BasementEngineering/halloween-ai-case/cad/fusion/ResidenEvilCase v15.iges

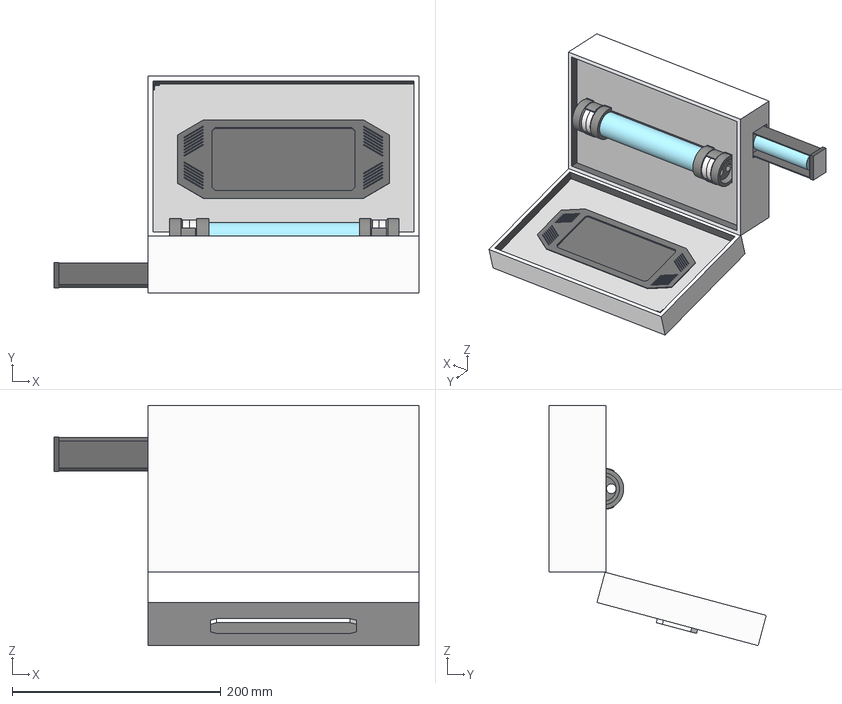
[picture p1: CAD file, 2026-11-10]
cad/fusion/ResidenEvilCase v15.iges
350.0 x 208.5 x 230.4 mm
