BasementEngineering/halloween-ai-case/cad/step/ResidenEvilCase v15.step

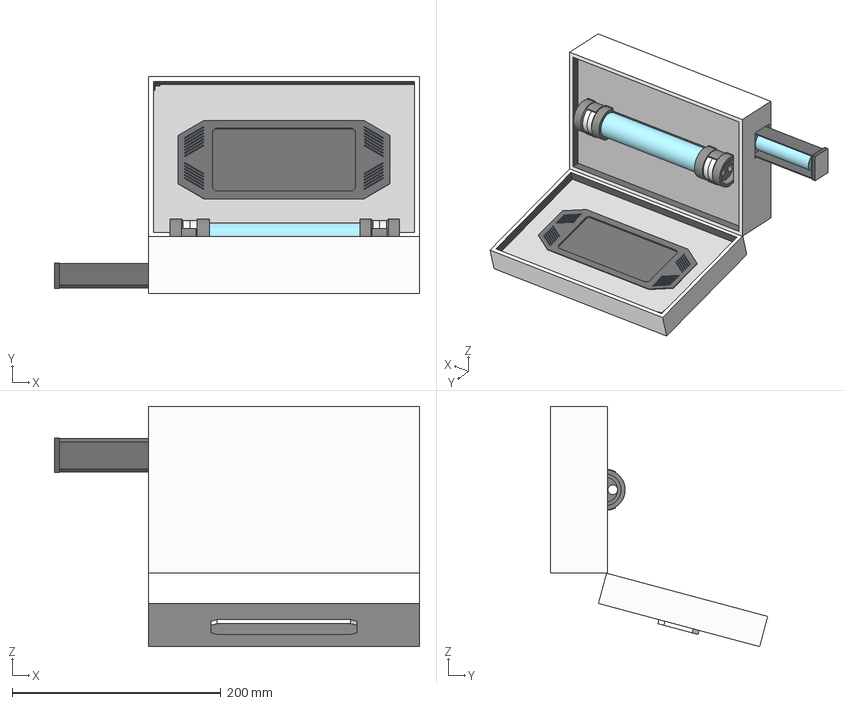
[picture p2: CAD file, 2026-11-10]
cad/step/ResidenEvilCase v15.step
350.0 x 208.5 x 230.4 mm
FogMachine
EndSwitch
DrawerSlide
Spur Gear 17 teeth
Vial
Holder
PhoneInsert
