BasementEngineering/halloween-ai-case/cad/stl/AntidoteReleaseMechanism/Drawer_Enclosure.stl

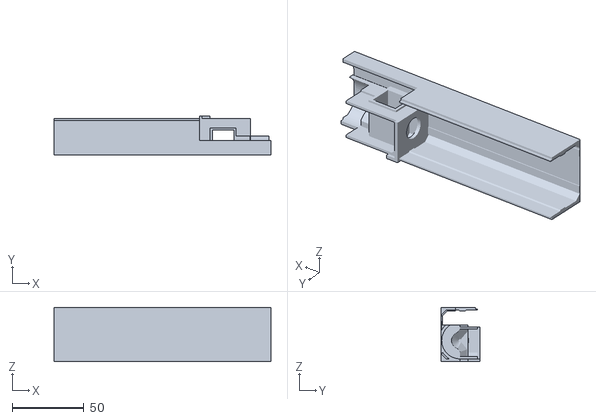
[picture p3: CAD file, 2026-11-10]
cad/stl/AntidoteReleaseMechanism/Drawer_Enclosure.stl
151.4 x 27.0 x 38.0
