BasementEngineering/halloween-ai-case/cad/stl/CornerPiece.stl

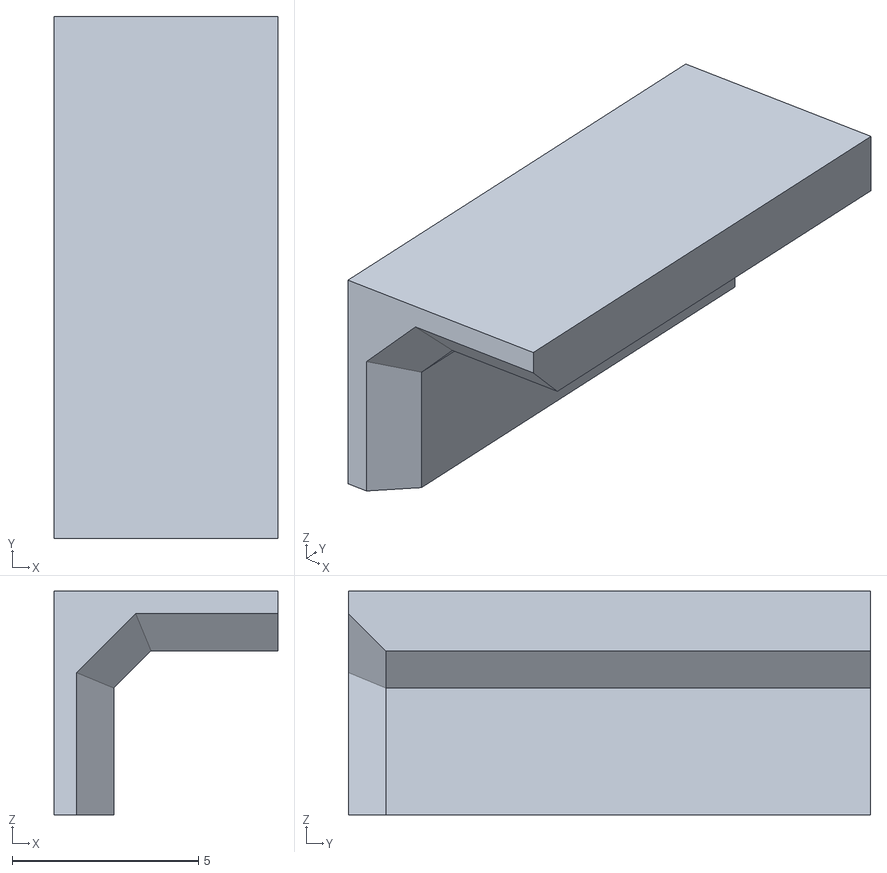
[picture p4: CAD file, 2026-11-10]
cad/stl/CornerPiece.stl
6.00 x 14.0 x 6.00
