BasementEngineering/halloween-ai-case/cad/stl/VialAndSensor/VialBottom_OuterPart.stl

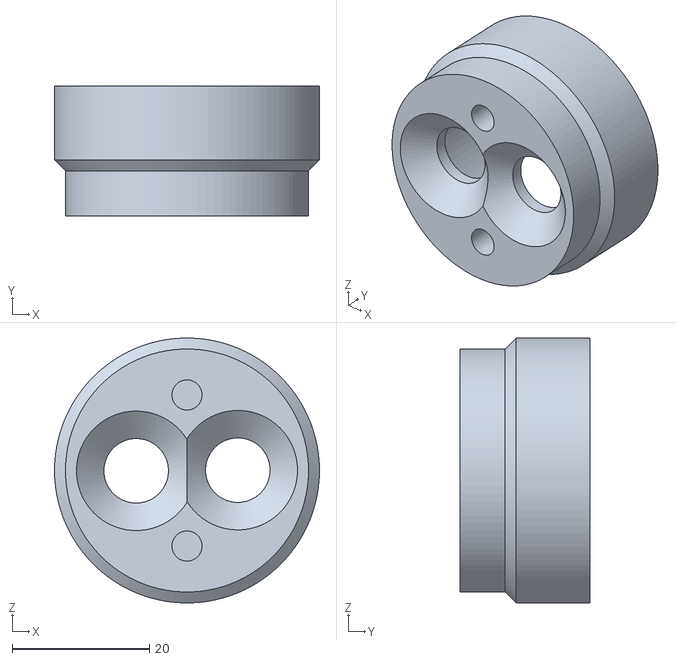
[picture p5: CAD file, 2026-11-10]
cad/stl/VialAndSensor/VialBottom_OuterPart.stl
38.6 x 19.0 x 38.6
