BasementEngineering/halloween-ai-case/cad/stl/AntidoteReleaseMechanism/RackCover.stl

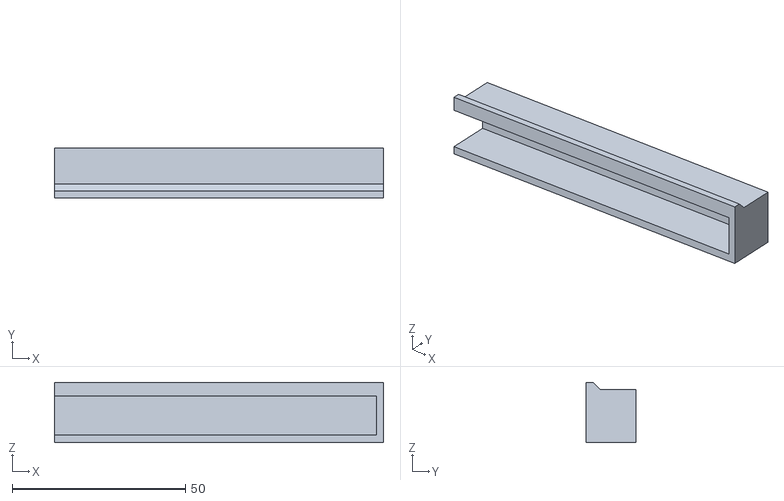
[picture p6: CAD file, 2026-11-10]
cad/stl/AntidoteReleaseMechanism/RackCover.stl
95.0 x 14.4 x 17.4
