BasementEngineering/halloween-ai-case/cad/stl/PhoneCover.stl

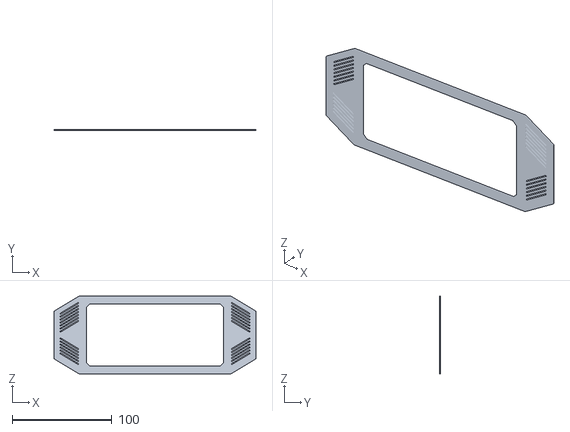
[picture p7: CAD file, 2026-11-10]
cad/stl/PhoneCover.stl
203.0 x 1.00 x 78.0
