BasementEngineering/halloween-ai-case/cad/stl/VialAndSensor/VialBottom_InnerPart.stl

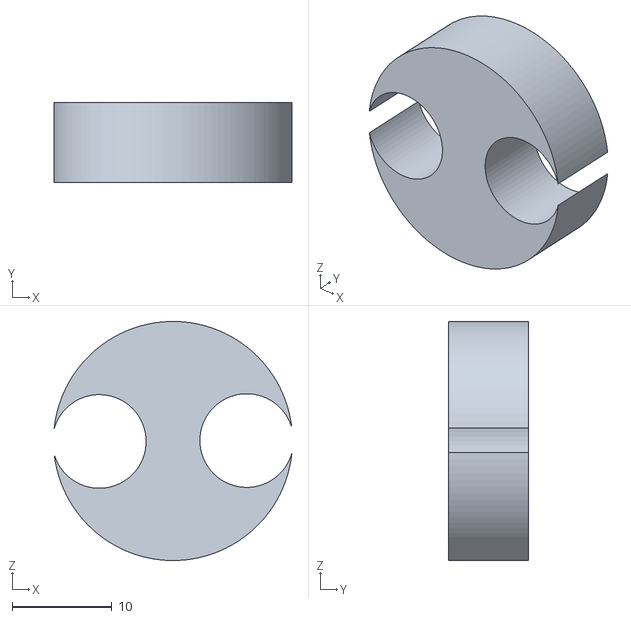
[picture p8: CAD file, 2026-11-10]
cad/stl/VialAndSensor/VialBottom_InnerPart.stl
23.9 x 8.00 x 24.0
