BasementEngineering/halloween-ai-case/cad/stl/AntidoteReleaseMechanism/Rack.stl

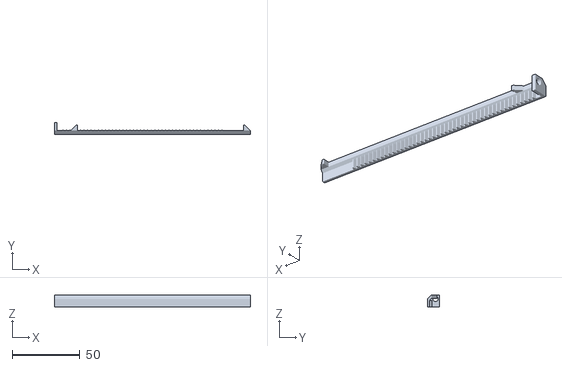
[picture p9: CAD file, 2026-11-10]
cad/stl/AntidoteReleaseMechanism/Rack.stl
145.0 x 9.00 x 9.20
