BasementEngineering/halloween-ai-case/cad/stl/VialAndSensor/VialTop_Part.stl

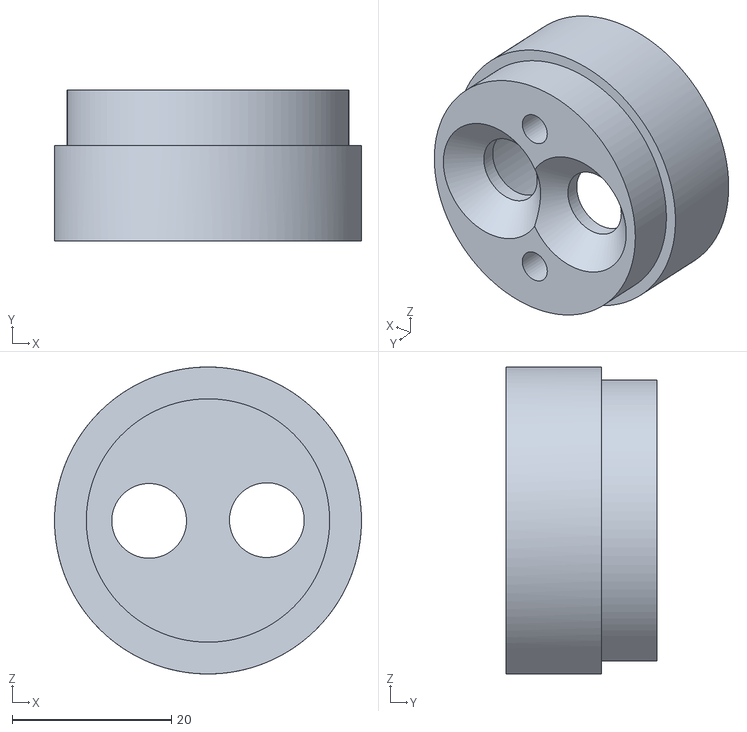
[picture p10: CAD file, 2026-11-10]
cad/stl/VialAndSensor/VialTop_Part.stl
38.6 x 19.0 x 38.6
