BasementEngineering/halloween-ai-case/cad/stl/AntidoteReleaseMechanism/gear.stl

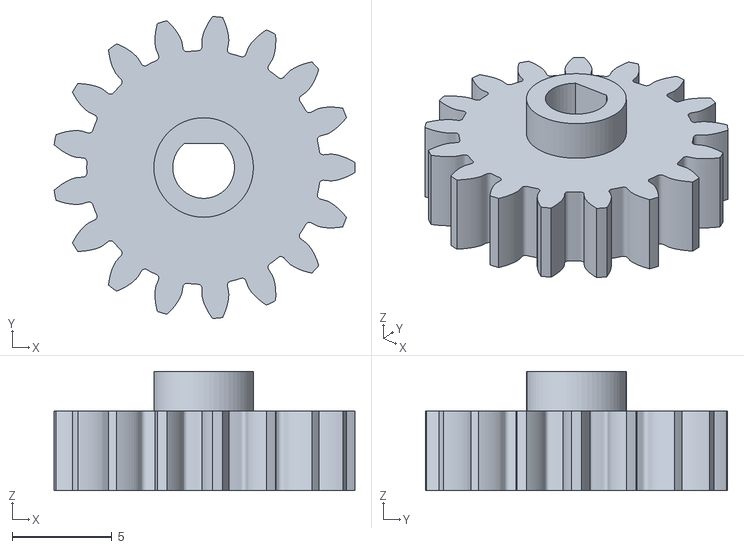
[picture p11: CAD file, 2026-11-10]
cad/stl/AntidoteReleaseMechanism/gear.stl
15.1 x 15.2 x 6.00
