BasementEngineering/halloween-ai-case/cad/stl/VialAndSensor/VialHolder.stl

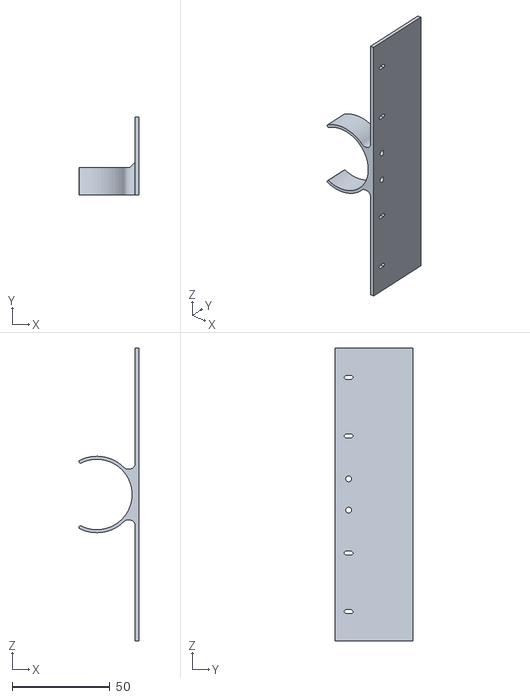
[picture p12: CAD file, 2026-11-10]
cad/stl/VialAndSensor/VialHolder.stl
30.8 x 40.0 x 150.0
