BasementEngineering/halloween-ai-case/cad/stl/AntidoteReleaseMechanism/Switch.stl

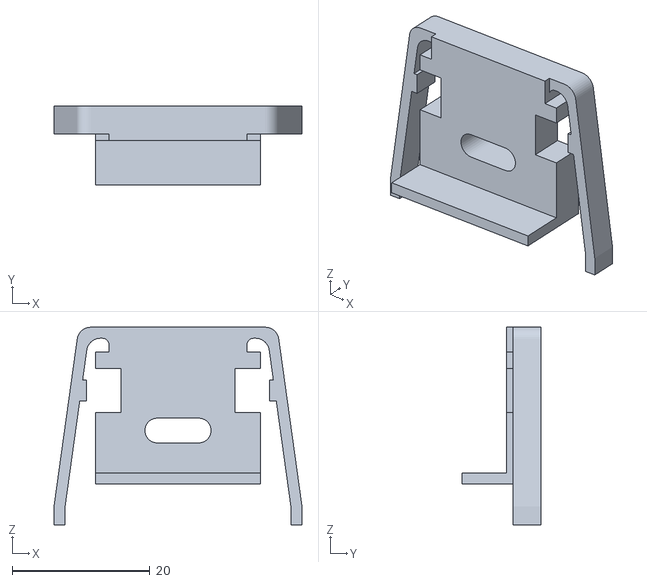
[picture p13: CAD file, 2026-11-10]
cad/stl/AntidoteReleaseMechanism/Switch.stl
36.0 x 11.4 x 28.7
