BasementEngineering/halloween-ai-case/cad/stl/VialAndSensor/VialHolder_Short.stl

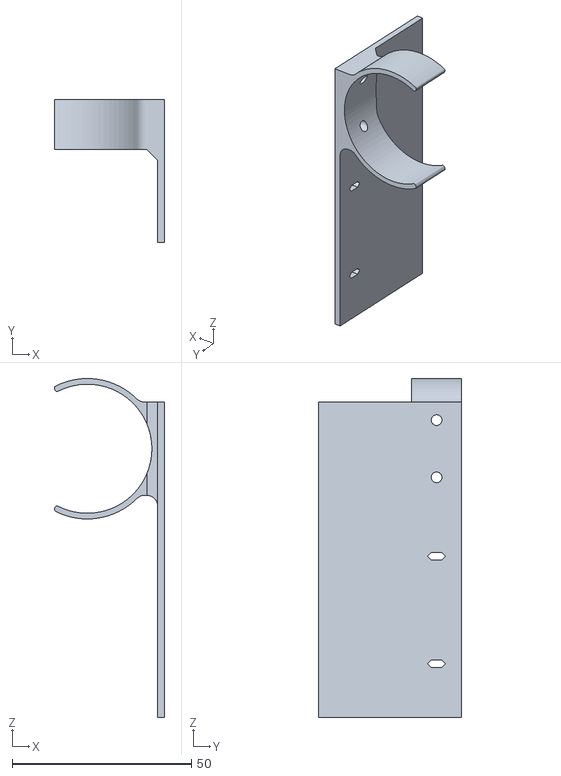
[picture p14: CAD file, 2026-11-10]
cad/stl/VialAndSensor/VialHolder_Short.stl
30.8 x 40.0 x 94.6
