BasementEngineering/halloween-ai-case/cad/stl/AntidoteReleaseMechanism/Drawer.stl

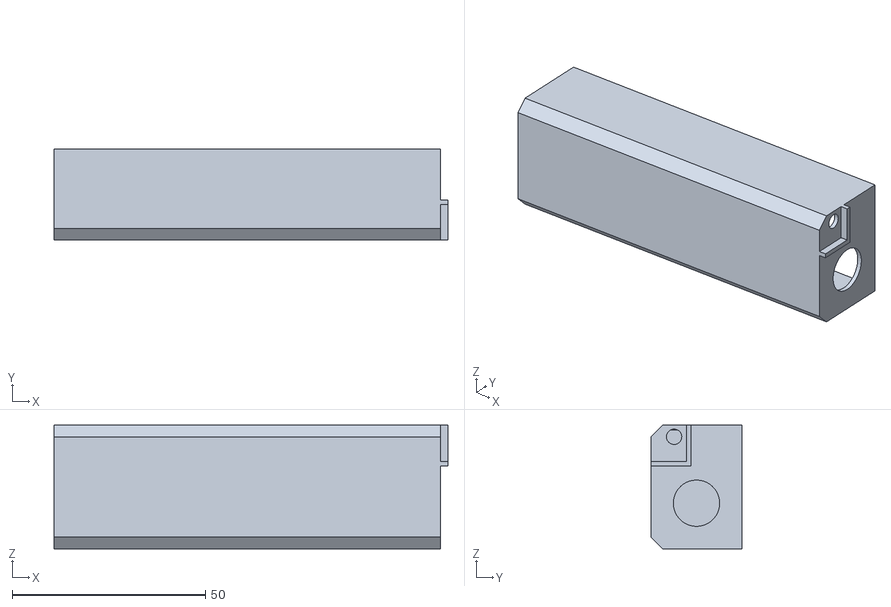
[picture p15: CAD file, 2026-11-10]
cad/stl/AntidoteReleaseMechanism/Drawer.stl
102.0 x 23.6 x 32.0
