BasementEngineering/halloween-ai-case/cad/stl/AntidoteReleaseMechanism/DrawerEnclosureCap.stl

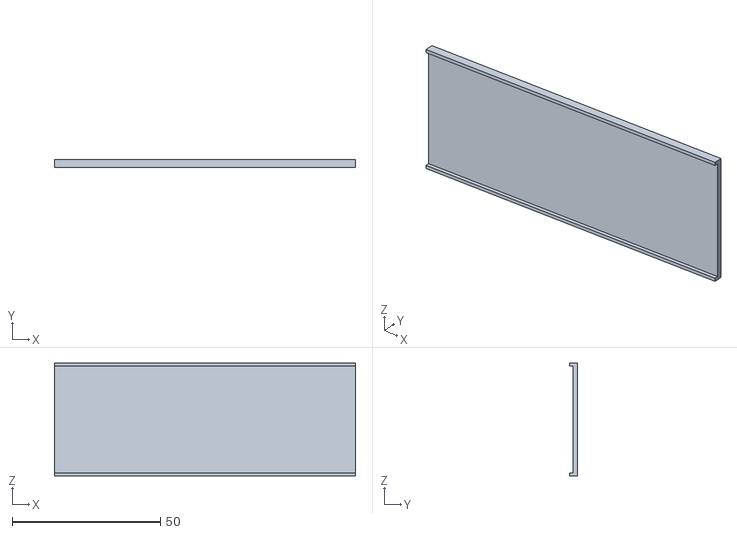
[picture p16: CAD file, 2026-11-10]
cad/stl/AntidoteReleaseMechanism/DrawerEnclosureCap.stl
101.4 x 2.70 x 38.0
