BasementEngineering/halloween-ai-case/cad/stl/AntidoteReleaseMechanism/3mmSpacer.stl

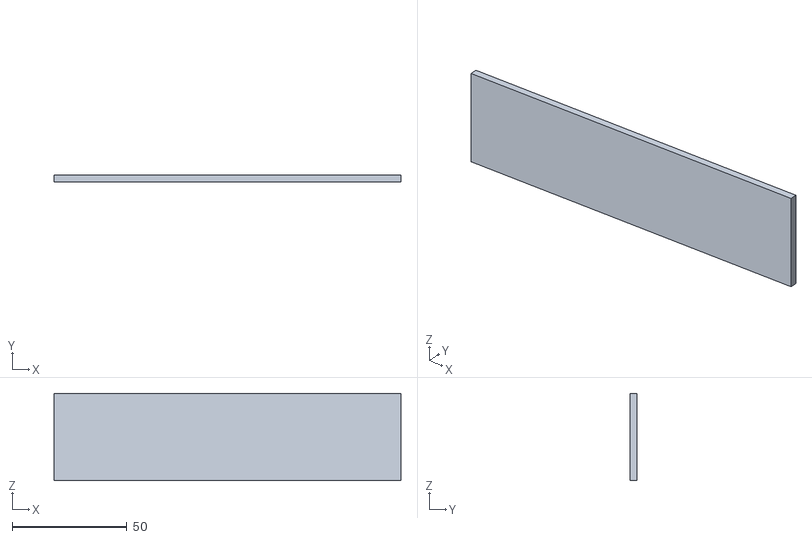
[picture p17: CAD file, 2026-11-10]
cad/stl/AntidoteReleaseMechanism/3mmSpacer.stl
151.4 x 3.00 x 38.0
