BasementEngineering/halloween-ai-case/cad/stl/AntidoteReleaseMechanism/WaterReservoir.stl

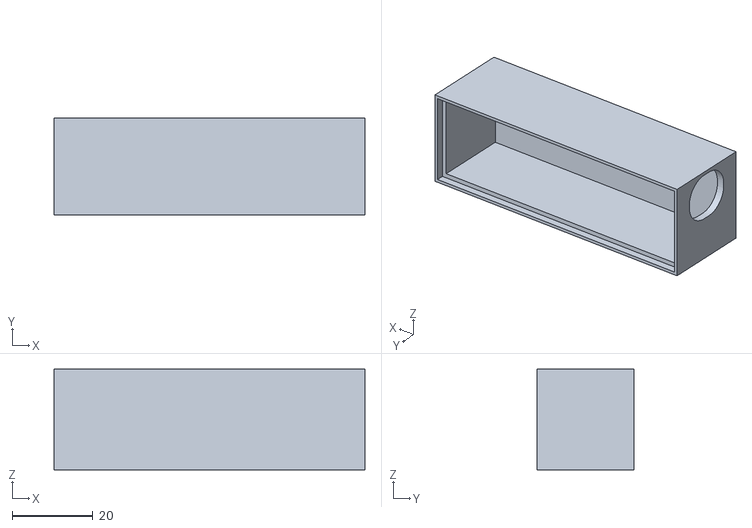
[picture p18: CAD file, 2026-11-10]
cad/stl/AntidoteReleaseMechanism/WaterReservoir.stl
77.0 x 24.0 x 25.0
