BasementEngineering/halloween-ai-case/cad/stl/AntidoteReleaseMechanism/SwitchBase.stl

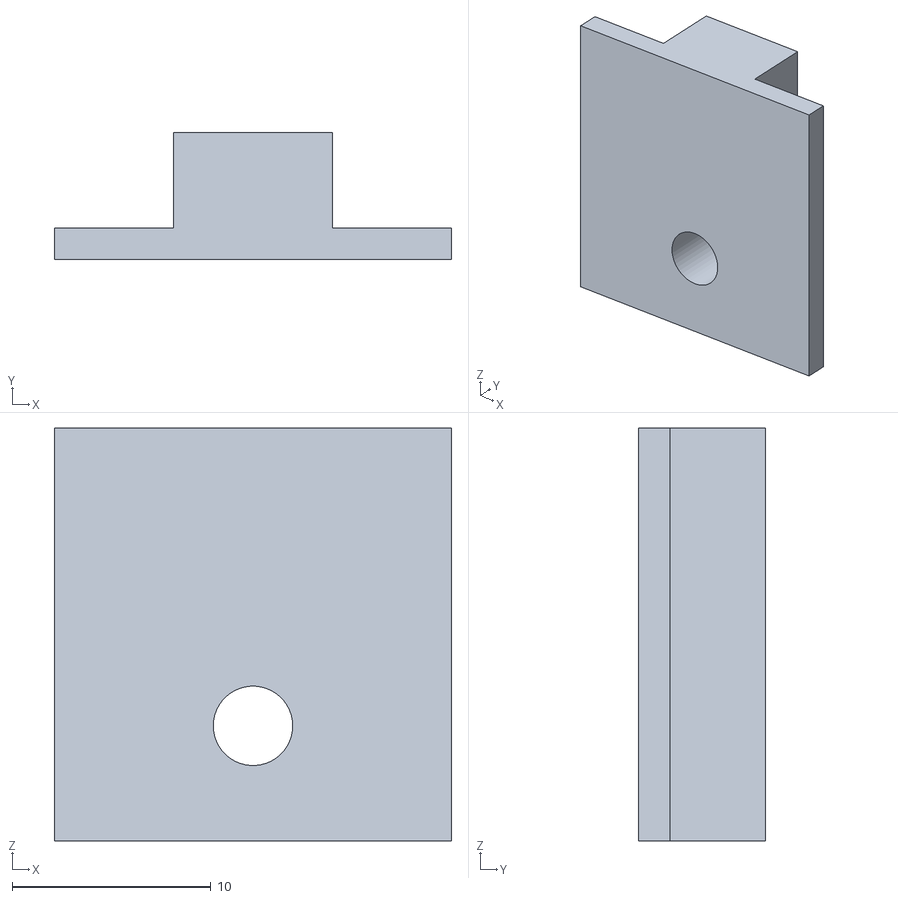
[picture p19: CAD file, 2026-11-10]
cad/stl/AntidoteReleaseMechanism/SwitchBase.stl
20.0 x 6.40 x 20.8
