BasementEngineering/halloween-ai-case/cad/stl/AntidoteReleaseMechanism/FogChamberCap.stl

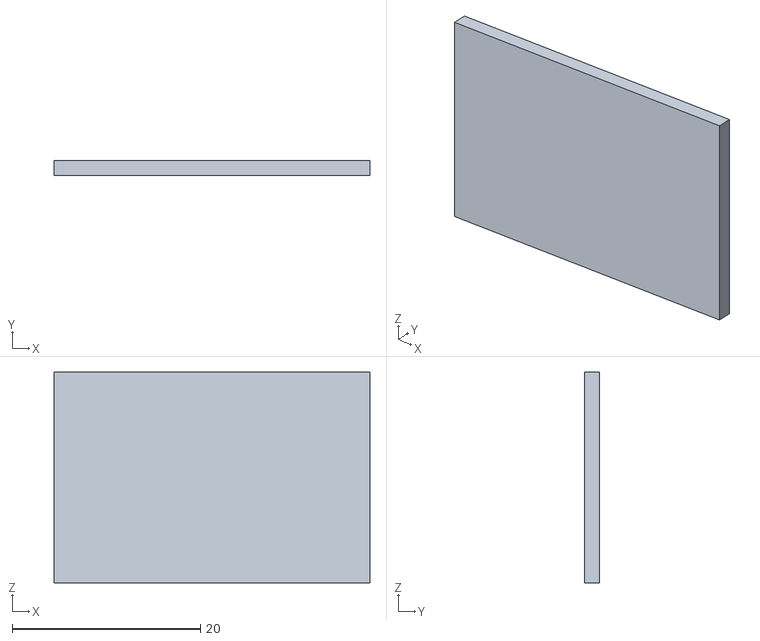
[picture p20: CAD file, 2026-11-10]
cad/stl/AntidoteReleaseMechanism/FogChamberCap.stl
33.6 x 1.60 x 22.4
