BasementEngineering/halloween-ai-case/cad/stl/AntidoteReleaseMechanism/WaterReservoirCap.stl

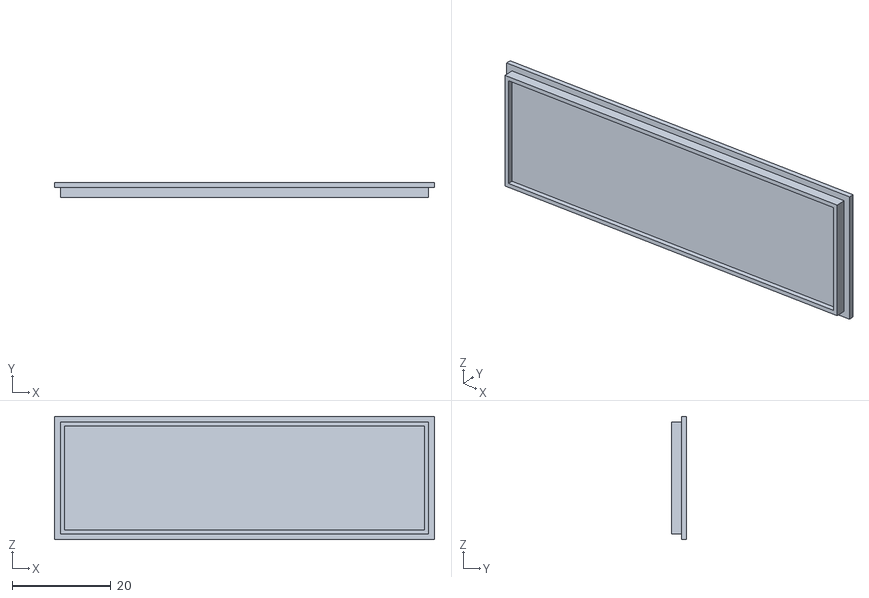
[picture p21: CAD file, 2026-11-10]
cad/stl/AntidoteReleaseMechanism/WaterReservoirCap.stl
77.0 x 3.00 x 25.0
