BasementEngineering/halloween-ai-case/(commit log)

2026-10-30 Red Queen case: web app, voice agent, docs
    Interactive upgrade of the 2024 Resident Evil prop case (still on laptop):
    - Mistral voice agents (English and German) created from the repo with
    npm run agent:sync; system prompts in docs/redqueen-persona.md
    - Test console and kiosk mode: case flow with standby logo, vial alarm,
    seal failure, startup animation, 3-minute game with trust meter and
    clearance code, win/fail endings
    - WebGL hologram renderer with expressions guessed from the game
    - Pre-recorded case computer and Red Queen lines (EN/DE), generated with
    npm run voicelines
    - Docs: concept, roadmap, setup guides, the 2024 case in oldcase.md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
    [Halloween_Case.ino, lights.h]
2026-10-30 ESP32 BLE test firmware and case link in the web app
    - firmware/esp32-ble-test: Nordic UART service "RedQueenCase", heartbeat
    every 2 s, BOOT button as fake vial, PING/PONG, re-advertising
    - CaseLink: Web Bluetooth connection with auto-reconnect and pings;
    vial events drive the case flow
    - Status dot on the screen (green/red, pulses on heartbeat)
    Claude-Session: https://claude.ai/code/session_01F8WkgaSkQSkztk812SJcQ4
2026-10-31 Case controller firmware for the ESP32-C3, app drives lights and drawer
    - firmware/redqueen-case: VL53L1X vial sensor, DRV8833 drawer with limit
    switches and timeout, mist maker, ported light effects, lid switch,
    override button, standalone mode, serial test commands
    - firmware/README.md: flashing, settings, calibration, protocol
    - docs/hardware.md: C3 pin map and wiring
    - App: white lights until the seal breaks, red/white blinking until the
    antidote is released; DRAWER:OPEN on a win, DRAWER:CLOSE on reset
    - Putting the vial back is ignored once the seal has broken
    - CaseLink queues BLE writes
    Claude-Session: https://claude.ai/co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
    [lights.h, redqueen-case.ino]
2026-11-02 Phone app with Capacitor: native Bluetooth, keep-awake, landscape kiosk
    The web app now runs on the Galaxy A40 as an Android app. It connects to the
    case over native BLE and reconnects by itself, keeps the screen on, and runs
    fullscreen in landscape with the timer and trust score on screen. The Mistral
    key and agent IDs are copied from .env into app-private storage over USB
    (npm run phone:config) and are never part of the APK or the repo.
    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
2026-11-04 Vial contacts, drawer LEDs, countdown lights and a hardware test mode
    Firmware 2.3 for the case controller:
    - Vial detection with two contacts on GPIO6 instead of the VL53L1X
    - One LED chain of 28: 15 inside the case, 8 logo, 5 drawer; the drawer
    LEDs glow green while the drawer is open
    - COUNTDOWN effect: the inside fills red from both ends over 10 s, the
    seal breaks after 7 s; standalone, putting the vial back resets it
    - "Drawer open" end switch enabled; DRAWER:STOP and DRAWER:OPEN:DRY
    - Test commands: LED:BRIGHTNESS, LED:COLOR per zone, end switch states,
    firmware version and every effect change reported
    App:
    - Sends the countdown to the case in step with the on-screen countdown
    -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
    [lights.h, redqueen-case.ino]
2026-11-04 White drawer light, hidden hardware test gesture, vial baseline fix
    Firmware 2.4:
    - The drawer LEDs breathe white while the drawer is opening, open or
    closing, and stay off when it's closed, stuck or unknown
    - Hardware test on the phone: tap the top-left corner 5 times within
    2 s (replaces holding the visible case dot)
    - Ask the case for its status once notifications are on. The status it
    sends on connect arrived too early, so the vial had no baseline and
    the first removal after a reconnect was ignored
    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
    [lights.h, redqueen-case.ino]
2026-11-04 Regenerate the reset voice line without the long pause
    RQ_20_RESET dragged: 13.8 s in German, and a 2.6 s gap after
    "Resetting containment" in English. Dropped the "…" pause from the line
    and regenerated both (now 7.6 s and 6.3 s).
2026-11-04 Setup screen on the phone: Mistral key, voice and clearance code
    So a downloaded APK works without the repo or a laptop:
    - Opens by itself when the app has no config, otherwise from the
    hardware test (new Setup button)
    - Paste a Mistral API key, load the account's voices (own voices first,
    then presets), enter the clearance code (needs a digit)
    - Saving creates or updates the red-queen agents in that account with
    the persona bundled in the app, writes files/config.json and restarts
    - Agent setup shared with npm run agent:sync (src/agent/sync.ts), so
    both build the same agents
    - phone:config also stores the voice, so the screen can preselect it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
2026-11-04 Keep the GLaDOS voice lines out of the repo
    The app never used them: they were the SD-card tracks of the 2024 case.
    The files stay on this machine, ignored by git. README now calls the case
    computer WARDEN-3.
2026-11-04 Read the voice line script and persona with Windows line endings
    With core.autocrlf, a Windows checkout has CRLF in the docs. The voice
    line parser then found no sections, and the persona prompt kept carriage
    returns. Both normalise line endings first; tests cover CRLF input.
2026-11-04 Generate the Red Queen's voice lines on the phone
    The APK ships no recordings of her voice anymore:
    - The setup screen generates all lines with the chosen voice and the
    player's own Mistral account (after Save, or with "Generate voice
    lines" / "Regenerate all"), stored in the app's private files
    - Only missing or changed lines are made; moderation failures are listed
    - The player plays generated lines first, then bundled ones; if her
    lines are missing at startup, the setup screen opens
    - Shared TTS settings and fingerprints with npm run voicelines
    (src/audio/tts.ts), so both make the same lines
    - Her lines and the manifest are git-ignored; only WARDEN-3's preset
    voice lines stay in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
2026-11-07 Closing the lid ends the game and puts the screen to sleep
    The lid is the single safe exit, and a closed case shouldn't drain the
    power bank:
    - Lid closed for 1 s: whatever runs ends silently, the Mistral session
    closes, the drawer closes and the mist stops
    - Opening the lid with the vial still out starts the normal run again;
    a vial removed while the lid is closed waits for the lid
    - In standby with the lid closed the screen goes black and as dim as
    it gets (screen-brightness plugin), while the app stays active and
    connected; opening it replays the label's fade-in
    - Not while the hardware test or setup is open, and never without a
    link to the case
    - The hologram stops drawing whil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
2026-11-07 Show a fresh timer and trust meter while she boots
    A second game showed the previous game's remaining time and trust until
    her intro had finished. The game now resets to full time and starting
    trust as soon as her startup animation begins.
2026-11-07 Case firmware 2.7: the lid resets the case, logo stays lit
    The lid now works the same with and without the app:
    - Closed for 1 s (LID_RESET_MS): an open drawer closes, the mist stops,
    the lights go back to standby
    - While it's closed the inside is dark whatever effect was running, and
    only the logo on the outside stays lit (LOGO_CLOSED_LEVEL)
    - Opened again with the vial still out, the countdown starts over
    - The standby light fades in over 1.5 s when the lid opens
    [lights.h, redqueen-case.ino]
2026-11-10 Warden III 1.1: new name, logo and a high score reset
    The app is now called Warden III, since it runs the whole case and not
    just the Red Queen. New launcher icon and splash screen (scripts/make-icon.py),
    and the hardware test can reset the high scores (tap twice to confirm).
    Release APK 1.1 (versionCode 2) replaces 1.0.
2026-11-10 Add the 3D-printed parts: STLs, STEP and IGES
    [3mmSpacer.stl, CornerPiece.stl, Drawer.stl, DrawerEnclosureCap.stl, Drawer_Enclosure.stl, FogChamberCap.stl, PhoneCover.stl, Rack.stl]
2026-11-10 BOM: match the parts actually built
    Printed rack and gear instead of the planned slip drive, tactile buttons as
    end switches, the reed switch used for the lid, two 470 uF capacitors, a
    power bank with two USB-A outputs (two switched cables, one for the phone),
    and the props and materials that were missing (glowsticks, aluminium tape,
    foam, acrylic for the logo, handcuffs).
2026-11-10 BOM: three cut USB cables and the micro USB charging port
2026-11-10 BOM: case height, handcuffs link
2026-11-10 BOM: rename the phone section to Phone and AI
2026-11-10 BOM: sort by subassembly, in the order of the build steps
2026-11-10 Add the outer bottom part of the vial
    [VialBottom_OuterPart.stl]
2026-11-10 CAD: VialTop_Part is printed three times
